raitraak-rrk/WiPoSense/Schematic.pdf

A | A
B | B
C | C
D | D

TITLE:
Overview | REV: 1.0

Date:

Sheet: 1/8
Drawn By: raitraak

Company:

USB
USB-C Connector
USB PD PHY
VBUS Voltage Measurement

USB_DATA

USB_VBUS

USB_VBUS
USB_LOAD_EN

POWER
External Power Input 5-24V, 20A Power Input Selector
USB Load Switch
PWM Supply Voltage Measurement 3V3/5V Power Supplies

PWM
PWM Outputs
PWM Control Signals

V_SUPPLY
PWM_OUT

Requirements
USB-C PD up to 100W
Alternate power input (5-24V 20A) Switched power outputs (4ch 5-24V 5A) BLE/ZigBee connectivity
Total board power dissipation below 2W

WiPoSense = Wireless Connectivity + Power (USB PD + PWM Outputs) + Sensor Connectivity

MCU
STM32WB
BLE + ZigBee
USB
Reset Switch
Debug UART
Debug/Trace
LEDs

USB_VBUS_MEAS

EXTENSION
I2C 1/2
ADC
Switch 1/2
Level Shifted Multi
Protocol IO
UART

USB_DATA
MCU_I2C

MCU_I2C
EXT_I2C
EXT_I2C

V_SUPPLY

EXT_ADC

PWM_OUT

EXT_LS_MP
EXT_LS_MP
EXT_SWITCH

EXT_UART

MCU_I2C | USB_LOAD_EN

EXT_UART

USB_VBUS_MEAS

V_PWM_MEAS

EXT_SWITCH
EXT_ADC

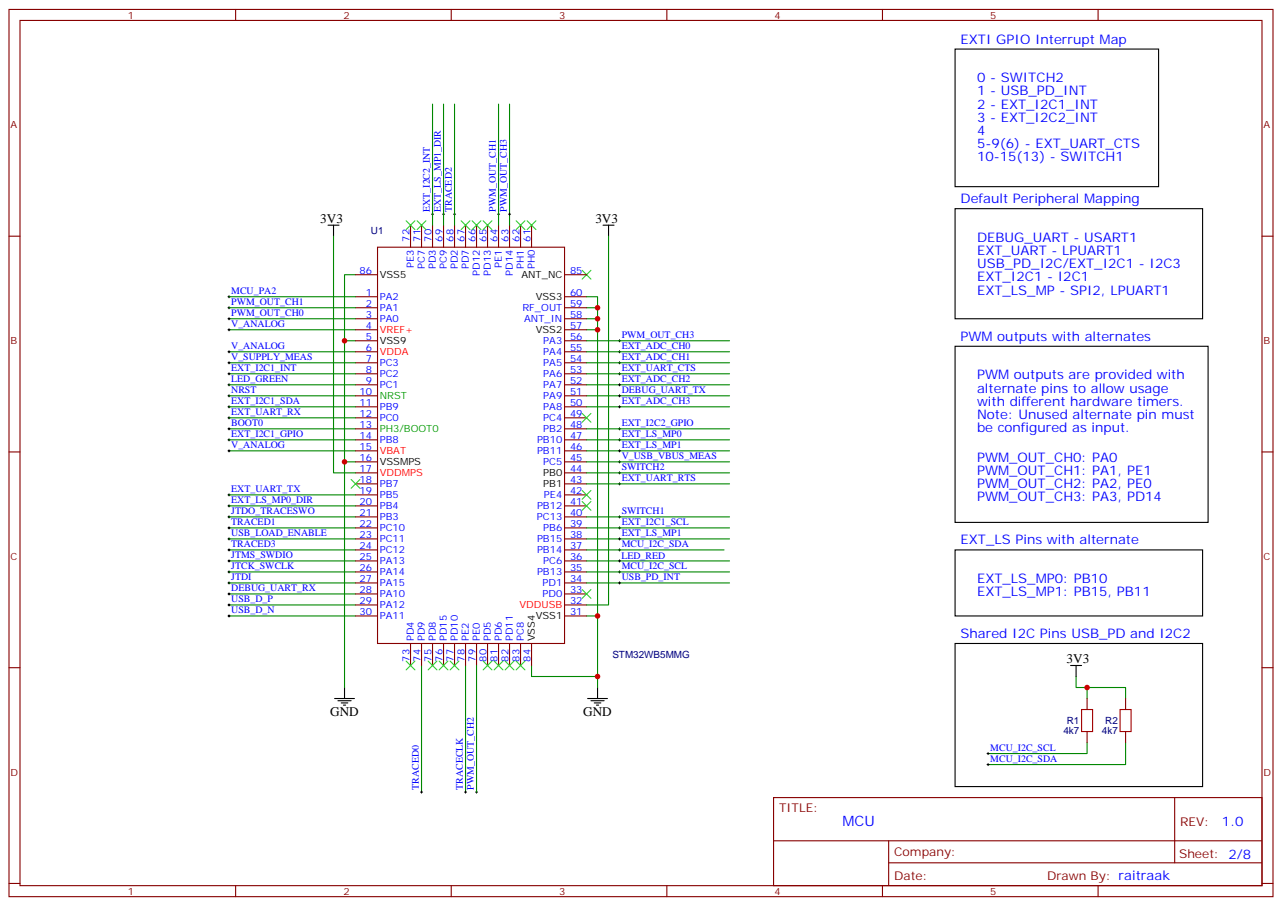
[picture p1: page 2]

EXTI GPIO Interrupt Map

PWM outputs with alternates

PWM outputs are provided with
alternate pins to allow usage
with different hardware timers.
Note: Unused alternate pin must
be configured as input.
PWM_OUT_CH0: PA0
PWM_OUT_CH1: PA1, PE1
PWM_OUT_CH2: PA2, PE0
PWM_OUT_CH3: PA3, PD14

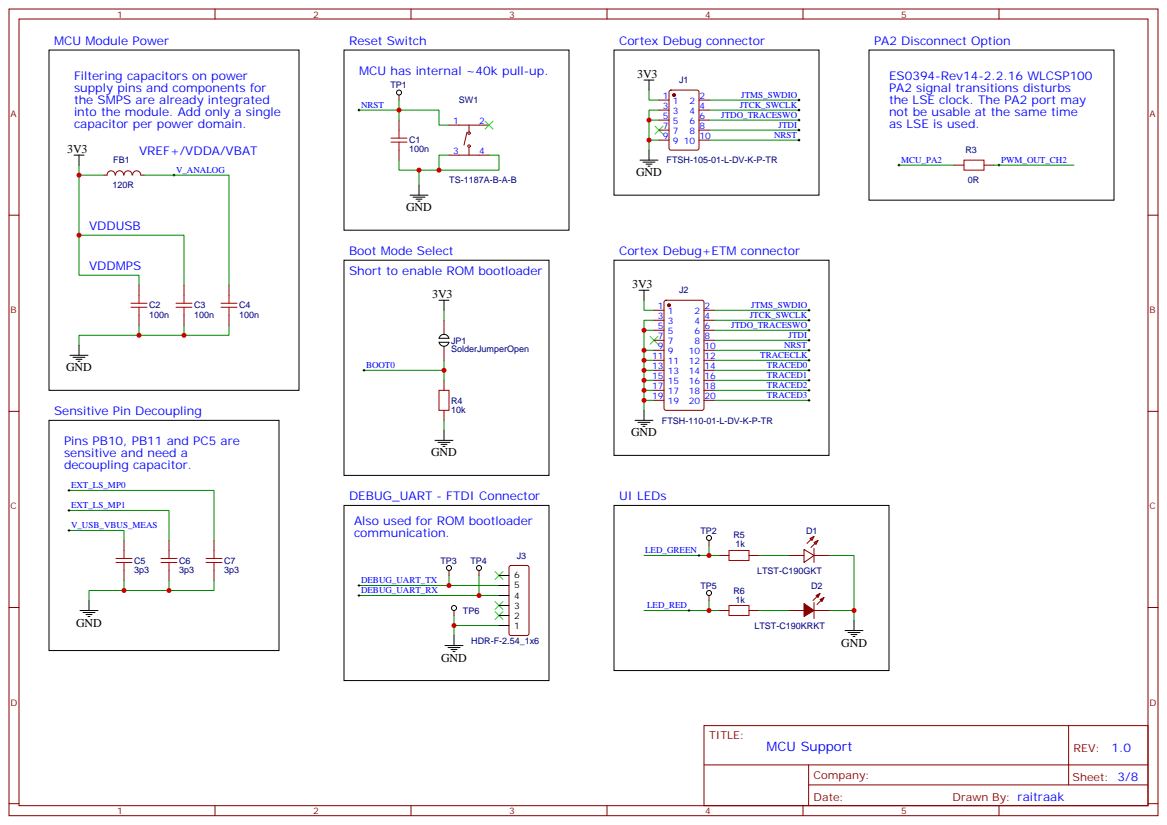
[picture p2: page 3]

MCU has internal ~40k pull-up.

Filtering capacitors on power
supply pins and components for
the SMPS are already integrated
into the module. Add only a single
capacitor per power domain.

ES0394-Rev14-2.2.16 WLCSP100
PA2 signal transitions disturbs
the LSE clock. The PA2 port may
not be usable at the same time
as LSE is used.

Boot Mode Select
Short to enable ROM bootloader

Cortex Debug+ETM connector

DEBUG_UART - FTDI Connector
Also used for ROM bootloader
communication.

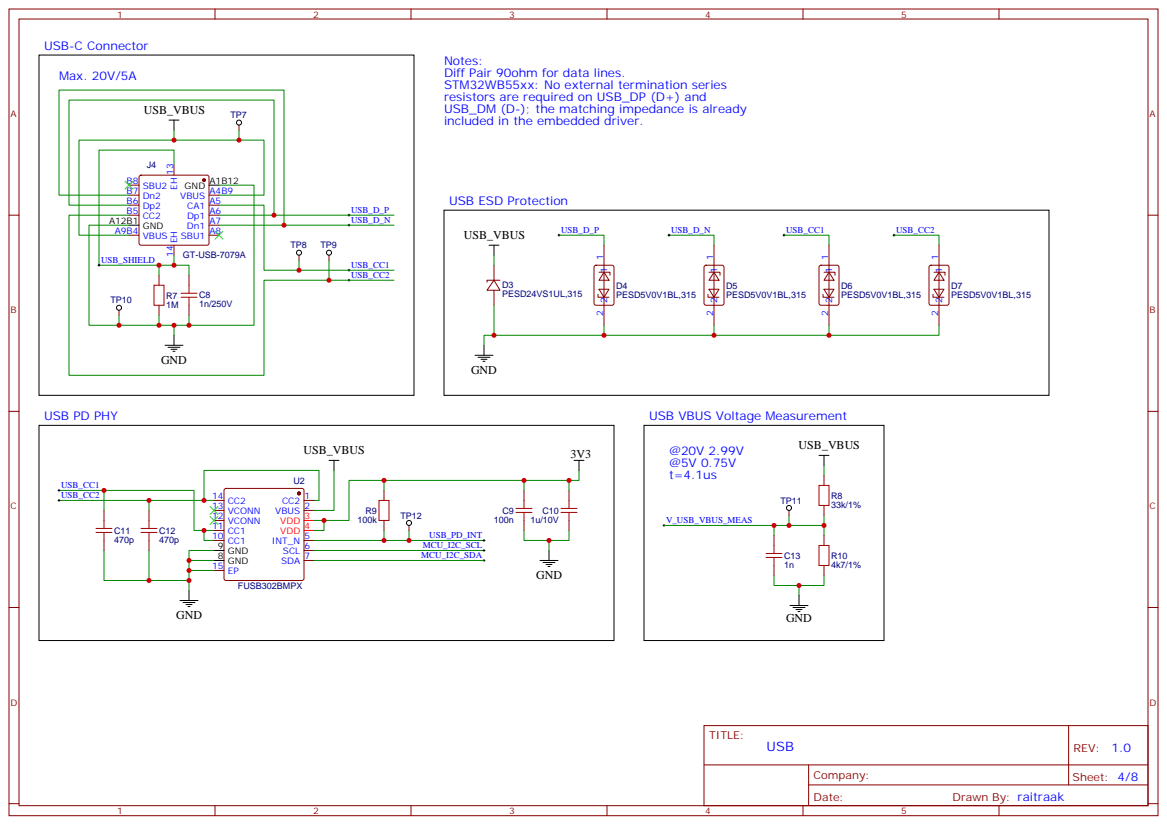
[picture p3: page 4]

Notes:
Diff Pair 90ohm for data lines.
STM32WB55xx: No external termination series
resistors are required on USB_DP (D+) and
USB_DM (D-); the matching impedance is already
included in the embedded driver.

USB VBUS Voltage Measurement

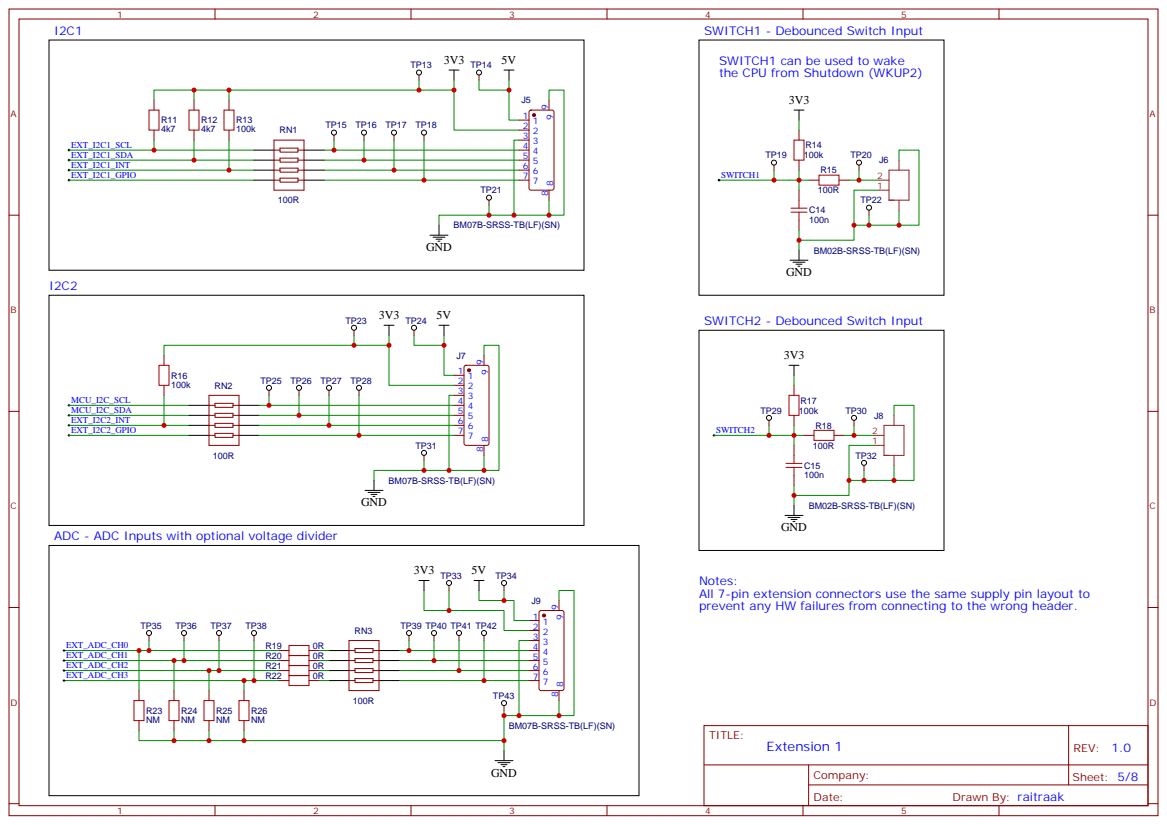
[picture p4: page 5]

the CPU from Shutdown (WKUP2)

BM07B-SRSS-TB(LF)(SN)
GND

BM02B-SRSS-TB(LF)(SN)

ADC - ADC Inputs with optional voltage divider

Notes:
All 7-pin extension connectors use the same supply pin layout to
prevent any HW failures from connecting to the wrong header.

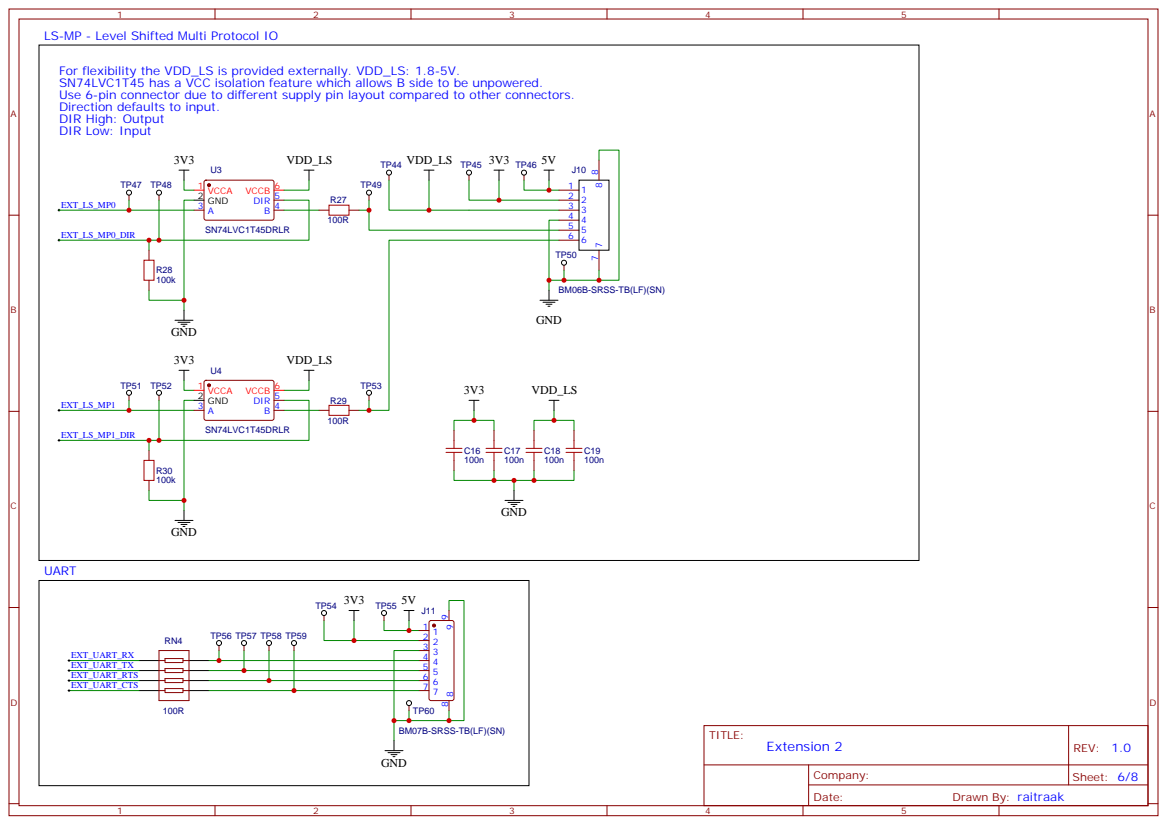
[picture p5: page 6]

LS-MP - Level Shifted Multi Protocol IO

For flexibility the VDD_LS is provided externally. VDD_LS: 1.8-5V.
SN74LVC1T45 has a VCC isolation feature which allows B side to be unpowered.
Use 6-pin connector due to different supply pin layout compared to other connectors.
Direction defaults to input.
DIR High: Output
DIR Low: Input

BM06B-SRSS-TB(LF)(SN)

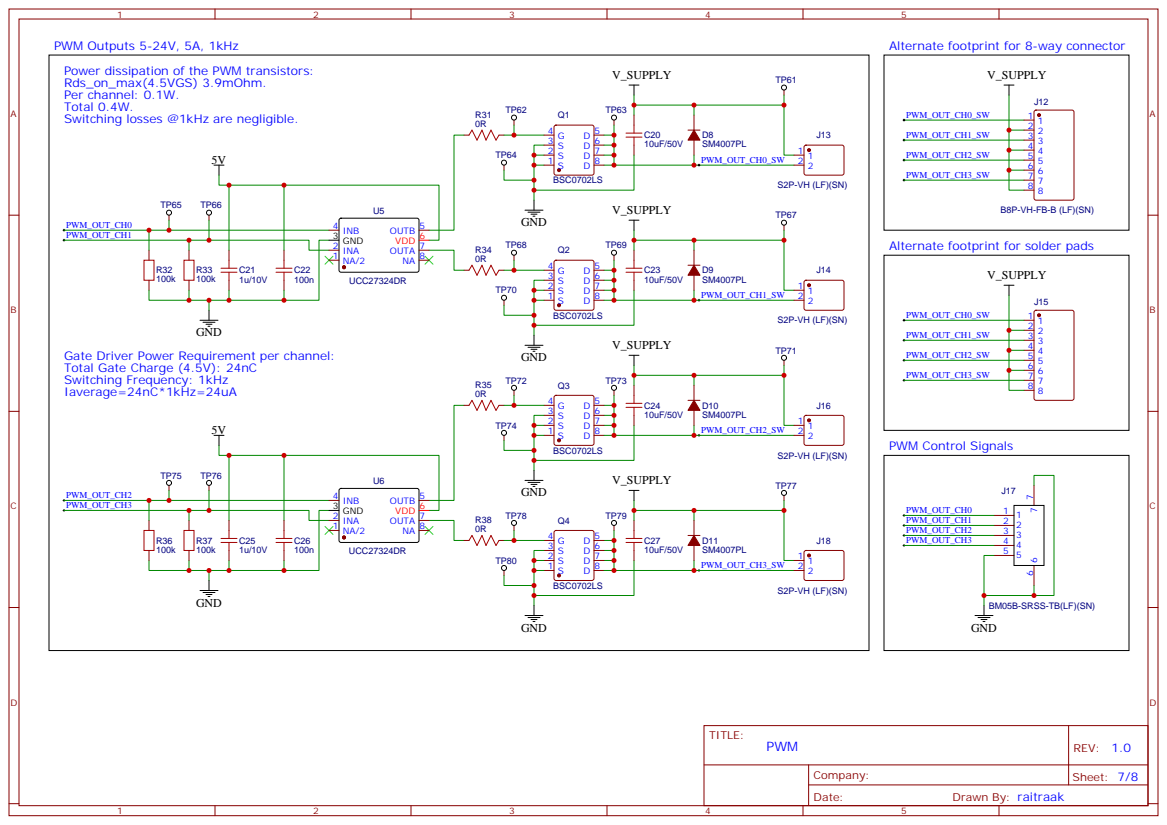
[picture p6: page 7]

PWM Outputs 5-24V, 5A, 1kHz
Power dissipation of the PWM transistors:
Rds_on_max(4.5VGS) 3.9mOhm.
Per channel: 0.1W.
Total 0.4W.
Switching losses @1kHz are negligible.

Alternate footprint for 8-way connector

Alternate footprint for solder pads

Gate Driver Power Requirement per channel:
Total Gate Charge (4.5V): 24nC
Switching Frequency: 1kHz
Iaverage=24nC*1kHz=24uA

BM05B-SRSS-TB(LF)(SN)
GND

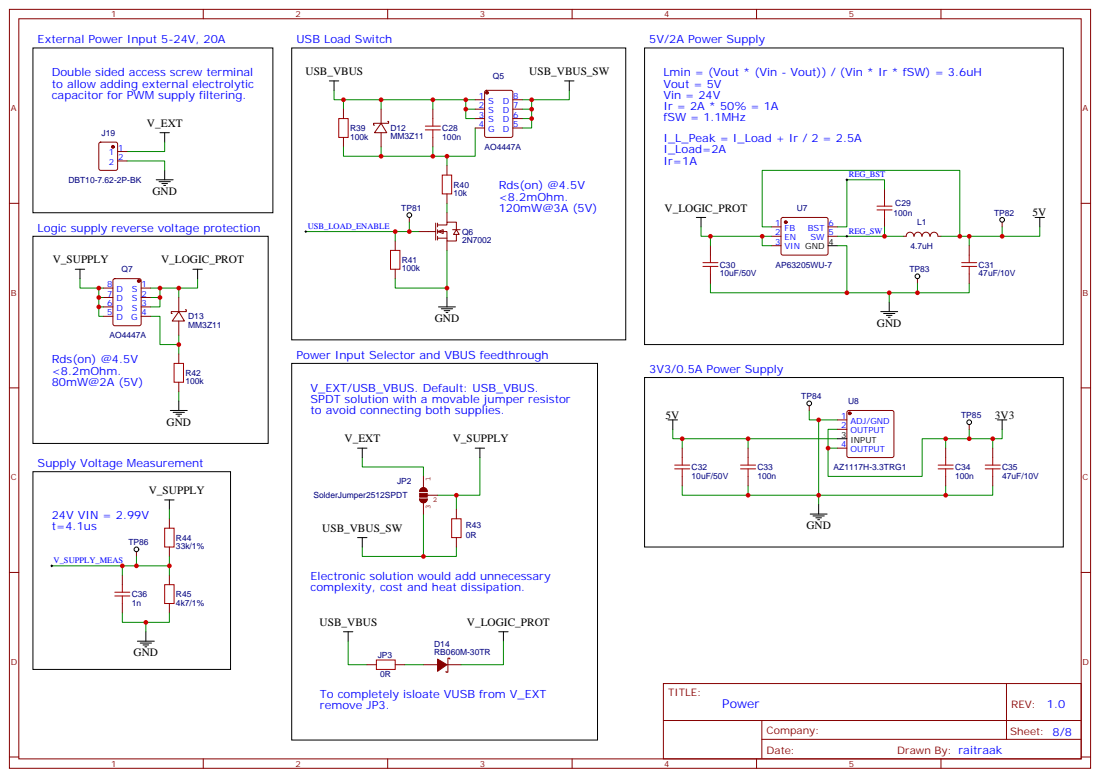
[picture p7: page 8]

Double sided access screw terminal
to allow adding external electrolytic
capacitor for PWM supply filtering.

Logic supply reverse voltage protection

Power Input Selector and VBUS feedthrough

V_EXT/USB_VBUS. Default: USB_VBUS.
SPDT solution with a movable jumper resistor
to avoid connecting both supplies.

Electronic solution would add unnecessary
complexity, cost and heat dissipation.

To completely isloate VUSB from V_EXT
remove JP3.
