raitraak-rrk/WiPoSense/Sim/PowerInputSelectAndReverseVoltageProtection.asc

C1: cap; 100n
D1: zener; BZX84B11VLY
D2: schottky; RB060MM-30
D3: zener; BZX84B11VLY
M1: pmos; AON6667_P
M2: pmos; AON6667_P
M4: nmos; 2N7002
R1: res; 100k
R2: res; 10k
R3: res; 100R
R4: res; 100k
R5: res; 0.001R
R6: res; 10R
V1: voltage; 24; Rser=0
V3: voltage; 20; Rser=0
V4: voltage; PULSE(0 3.3 1 100n 100n 1); Rser=0
Named nets: 0, V_LOGIC_PROT, V_SUPPLY, V_EXT, USB_VBUS_SW, USB_VBUS
.tran 0 1.001 0.999
