raitraak-rrk/WiPoSense/(list of files, drawings)

Other design files:
EasyEDA/PCB_WiPoSense.json
EasyEDA/SCH_WiPoSense.json
