raitraak-rrk/WiPoSense/WiPoSense.ioc

Mcu.UserName=STM32WB5MMGHx
PA0.GPIO_Label=PWM0 
PA0.Signal=S_TIM2_CH1
PA1.GPIO_Label=PWM1 
PA1.Signal=S_TIM2_CH2
PA10.GPIO_Label=DEBUG_UART_RX 
PA10.Signal=USART1_RX
PA11.GPIO_Label=USB_D_N 
PA11.Signal=USB_DM
PA12.GPIO_Label=USB_D_P 
PA12.Signal=USB_DP
PA13.GPIO_Label=JTMS_SWDIO 
PA13.Signal=SYS_JTMS-SWDIO
PA14.GPIO_Label=JTCK_SWCLK 
PA14.Signal=SYS_JTCK-SWCLK
PA15.GPIO_Label=JTDI 
PA15.Signal=SYS_JTDI
PA2.GPIO_Label=PWM2 
PA2.Signal=S_TIM2_CH3
PA3.GPIO_Label=PWM3 
PA3.Signal=S_TIM2_CH4
PA4.GPIO_Label=EXT_ADC_CH0 
PA4.Signal=ADCx_IN9
PA5.GPIO_Label=EXT_ADC_CH1 
PA5.Signal=ADCx_IN10
PA6.GPIO_Label=EXT_UART_CTS 
PA6.Signal=LPUART1_CTS
PA7.GPIO_Label=EXT_ADC_CH2 
PA7.Signal=ADCx_IN12
PA8.GPIO_Label=EXT_ADC_CH3 
PA8.Signal=ADCx_IN15
PA9.GPIO_Label=DEBUG_UART_TX 
PA9.Signal=USART1_TX
PB0.GPIO_Label=SWITCH2 
PB0.Signal=GPIO_Input
PB1.GPIO_Label=EXT_UART_RTS 
PB1.Signal=LPUART1_RTS
PB10.GPIO_Label=EXT_LS_MP0 
PB10.Signal=SPI2_SCK
PB11.GPIO_Label=EXT_LS_MP1 
PB11.Signal=GPIO_Output
PB13.GPIO_Label=MCU_I2C_SCL
PB13.Signal=I2C3_SCL
PB14.GPIO_Label=MCU_I2C_SDA 
PB14.Signal=I2C3_SDA
PB15.GPIO_Label=EXT_LS_MP1 
PB15.Signal=SPI2_MOSI
PB2.GPIO_Label=EXT_I2C2_GPIO 
PB2.Signal=GPIO_Output
PB3.GPIO_Label=JTDO_TRACESWO 
PB3.Signal=SYS_JTDO-SWO
PB4.GPIO_Label=EXT_LS_MP0_DIR 
PB4.Signal=GPIO_Output
PB5.GPIO_Label=EXT_UART_TX 
PB5.Signal=LPUART1_TX
PB6.GPIO_Label=EXT_I2C1_SCL 
PB6.Signal=I2C1_SCL
PB8.GPIO_Label=EXT_I2C1_GPIO 
PB8.Signal=GPIO_Output
PB9.GPIO_Label=EXT_I2C1_SDA 
PB9.Signal=I2C1_SDA
PC0.GPIO_Label=EXT_UART_RX 
PC0.Signal=LPUART1_RX
PC1.GPIO_Label=LED_GREEN 
PC1.Signal=GPIO_Output
PC10.GPIO_Label=TRACED1 
PC10.Signal=SYS_TRACED1
PC11.GPIO_Label=USB_LOAD_ENABLE
PC11.Signal=GPIO_Output
PC12.GPIO_Label=TRACED3 
PC12.Signal=SYS_TRACED3
PC13.GPIO_Label=SWITCH1 
PC13.Signal=GPIO_Input
PC2.GPIO_Label=EXT_I2C1_INT 
PC2.Signal=GPIO_Input
PC3.GPIO_Label=V_SUPPLY_MEAS 
PC3.Signal=ADCx_IN4
PC5.GPIO_Label=V_USB_VBUS_MEAS 
PC5.Signal=ADCx_IN14
PC6.GPIO_Label=LED_RED 
PC6.Signal=GPIO_Output
PC9.GPIO_Label=EXT_LS_MP1_DIR 
PC9.Signal=GPIO_Output
PD1.GPIO_Label=USB_PD_INT
PD1.Signal=GPIO_Input
PD14.GPIO_Label=PWM_OUT_CH3 
PD14.Signal=S_TIM1_CH1
PD2.GPIO_Label=TRACED2 
PD2.Signal=SYS_TRACED2
PD3.GPIO_Label=EXT_I2C2_INT 
PD3.Signal=GPIO_Input
PD9.GPIO_Label=TRACED0 
PD9.Signal=SYS_TRACED0
PE0.GPIO_Label=PWM_OUT_CH2 
PE0.Signal=S_TIM16_CH1
PE1.GPIO_Label=PWM_OUT_CH1 
PE1.Signal=S_TIM17_CH1
PE2.GPIO_Label=TRACECLK 
PE2.Signal=SYS_TRACECLK
PH3-BOOT0.GPIO_Label=BOOT0 
PH3-BOOT0.Signal=GPIO_Input
